ryood/MIDI_CV_CONV/Arduino/readme.txt

MIDI_CV_CONV     Releaseバージョン

MIDI_CV_Test01   Gateを6ch出力
MIDI_CV_Test02   同期してGATEを出力
MIDI_CV_Test03   CV x 2ch (dummy)
MIDI_CV_Test04   CV: ch1:Freq ch:Mod
MIDI_CV_Test05   CV出力をVolt/Octに変更
MIDI_CV_Test06   VRFEFを調整

MIDI_Display_Message_I2C_LCD      MIDIメッセージをUARTで表示
MIDI_Display_Message_I2C_LCD_Gate + GATE出力
