ryood/MIDI_CV_CONV/Arduino MIDI-CV Converter テスト.png

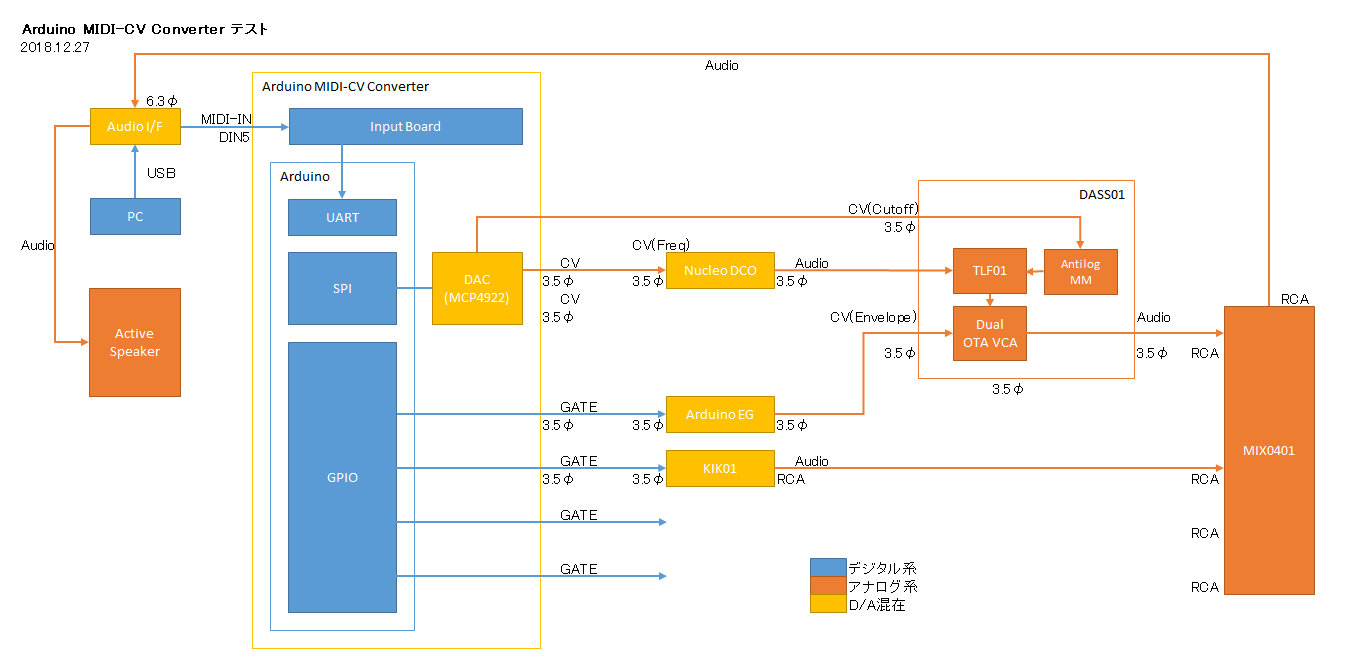
Arduino MIDI-CV Converter テスト.png
