ryood/MIDI_CV_CONV/Arduino MIDI-CV Converter 使用例.png

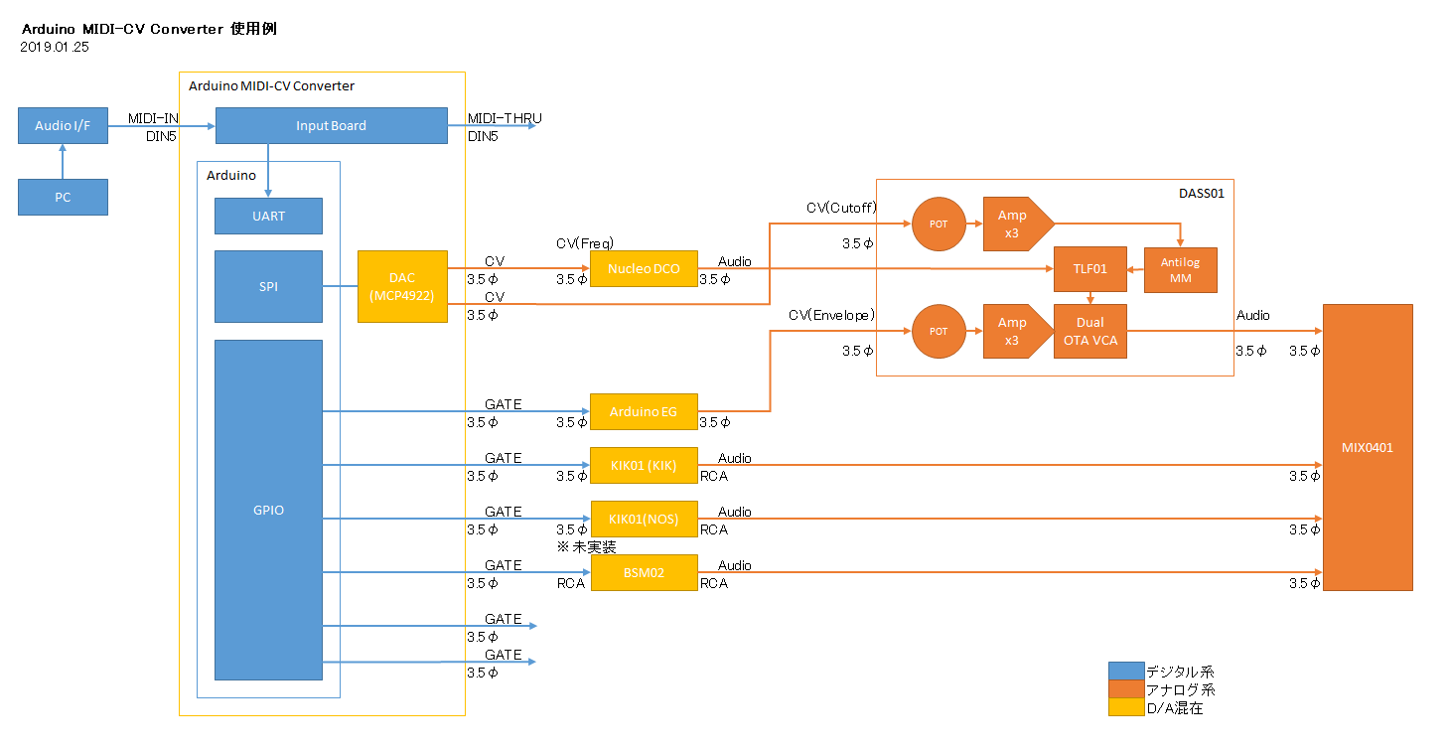
Arduino MIDI-CV Converter 使用例.png
