ryood/MIDI_CV_CONV/eagle/MIDI_CV_CONV/MIDI_CV_CONV_brd.png

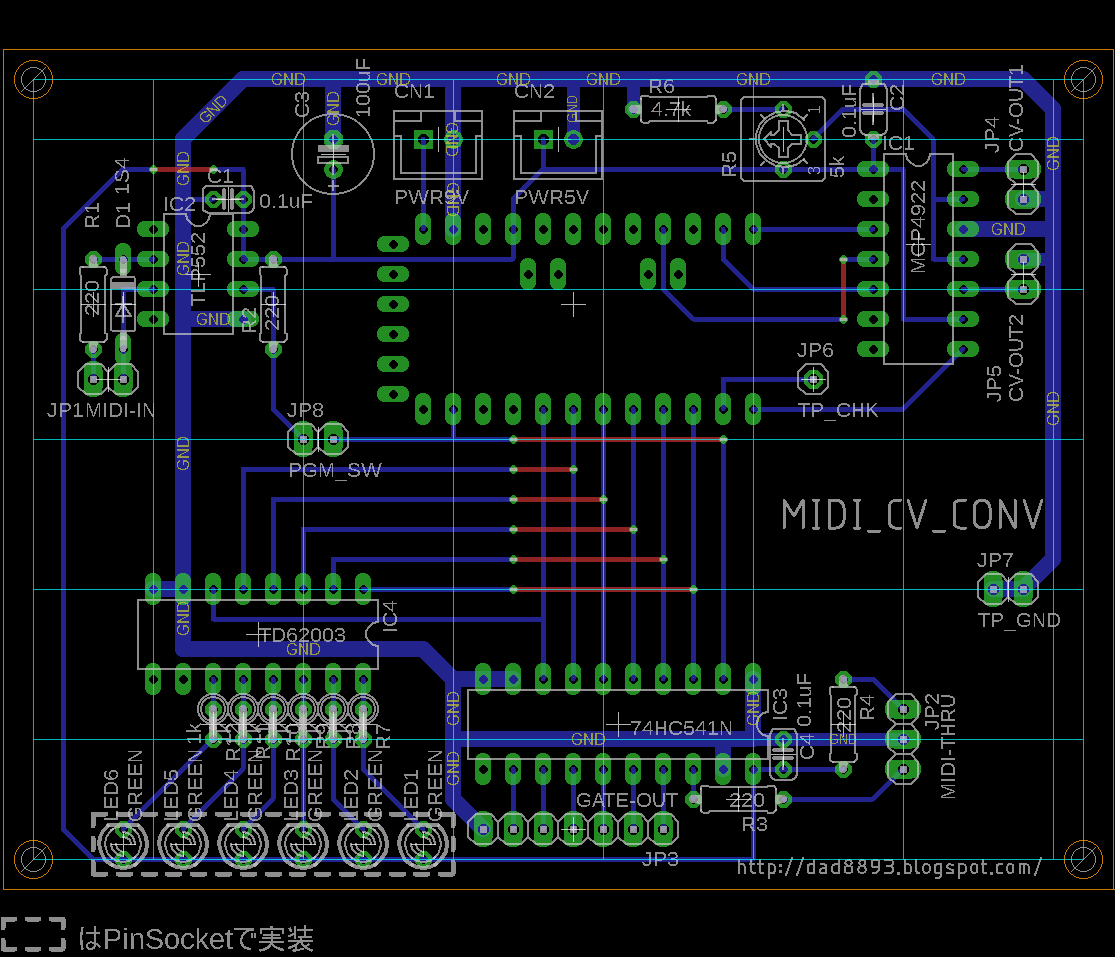
eagle/MIDI_CV_CONV/MIDI_CV_CONV_brd.png
