ryood/MIDI_CV_CONV/eagle/MIDI_CV_CONV/MIDI_CV_CONV_sch.png

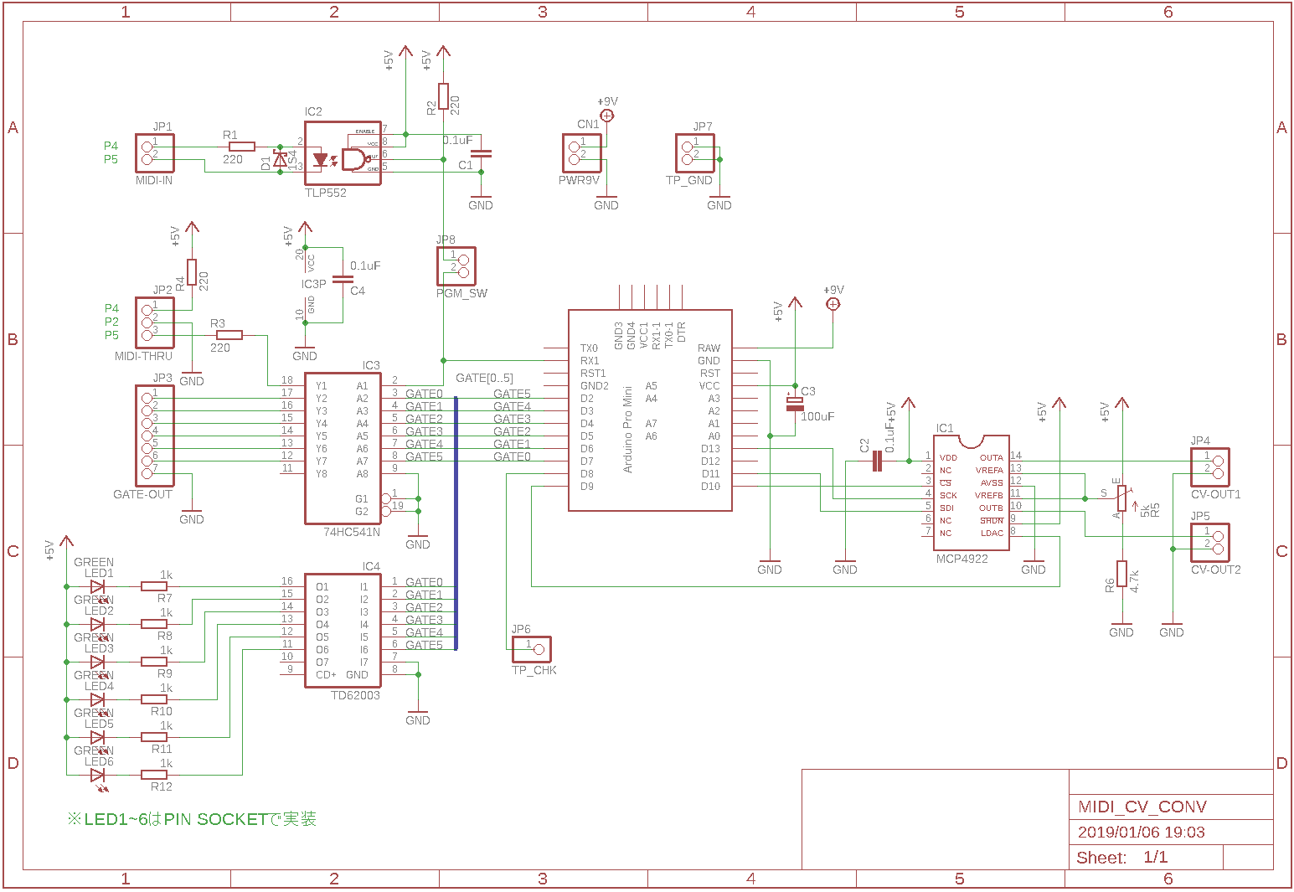
eagle/MIDI_CV_CONV/MIDI_CV_CONV_sch.png
