ryood/MIDI_CV_CONV/Fritzing/MIDI_CV_CONV_ブレッドボード.png

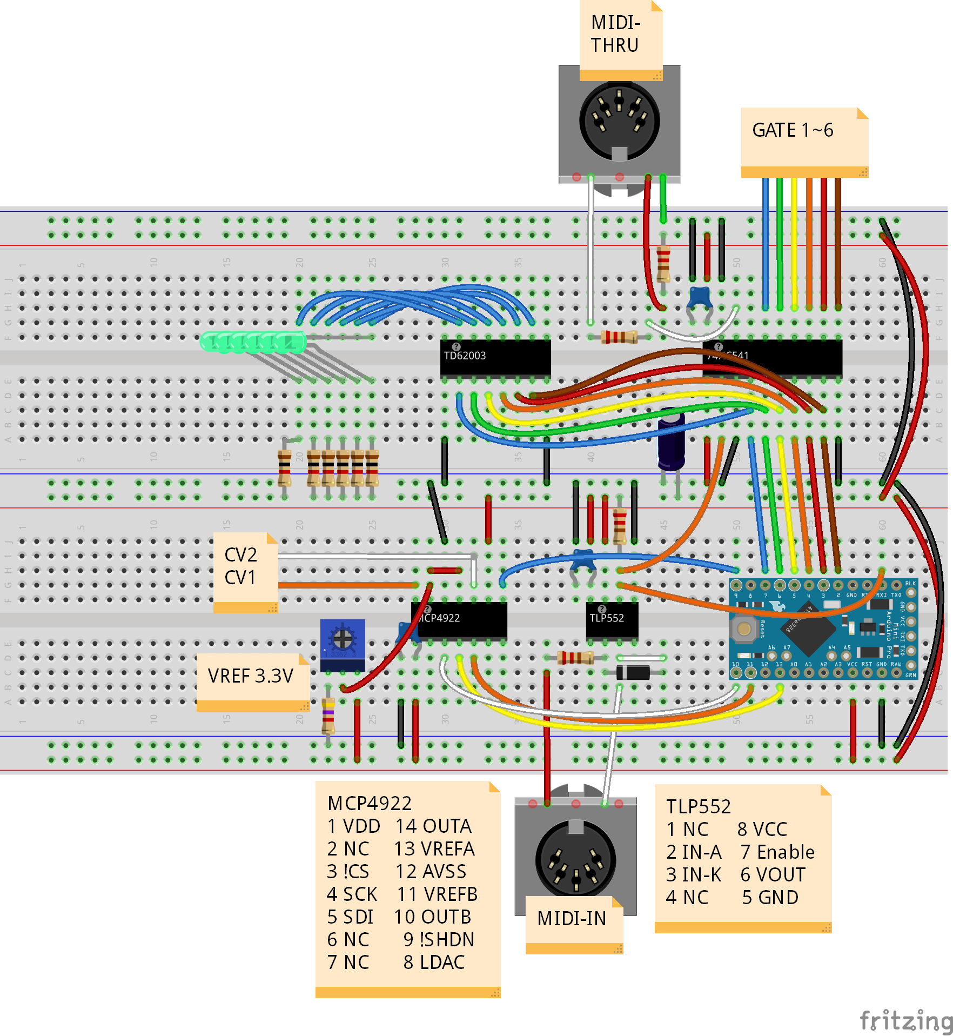
Fritzing/MIDI_CV_CONV_ブレッドボード.png
