ryood/MIDI_CV_CONV/MIDI_CV_CONV ブロック図.png

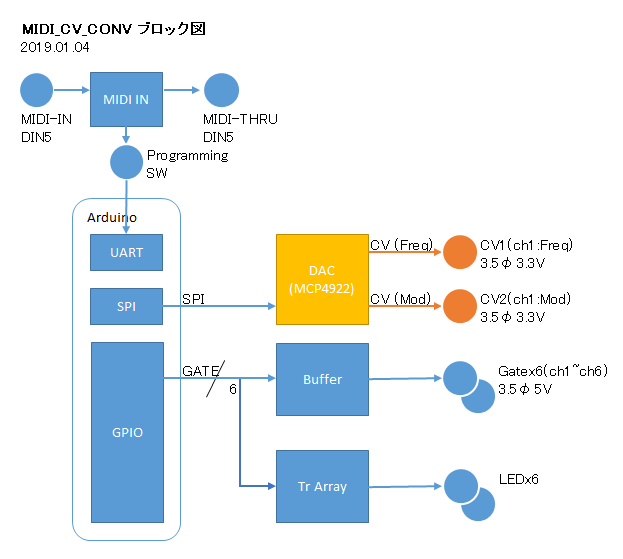
MIDI_CV_CONV ブロック図.png
