ryood/MIDI_CV_CONV/MIDI_CV_CONV+Nucleo_DCO/NucleoDCO+MIDI_CV_CONVブロック図.png

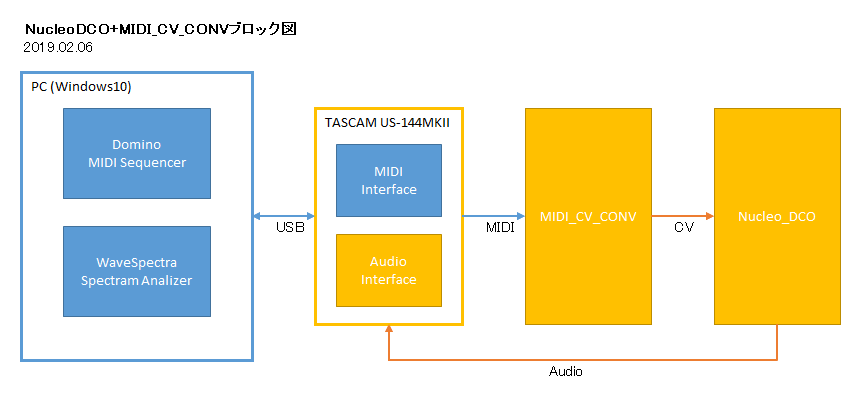
MIDI_CV_CONV+Nucleo_DCO/NucleoDCO+MIDI_CV_CONVブロック図.png
