ryood/MIDI_CV_CONV/MIDI_CV_CONV+Nucleo_DCO/Octave_Graph.png

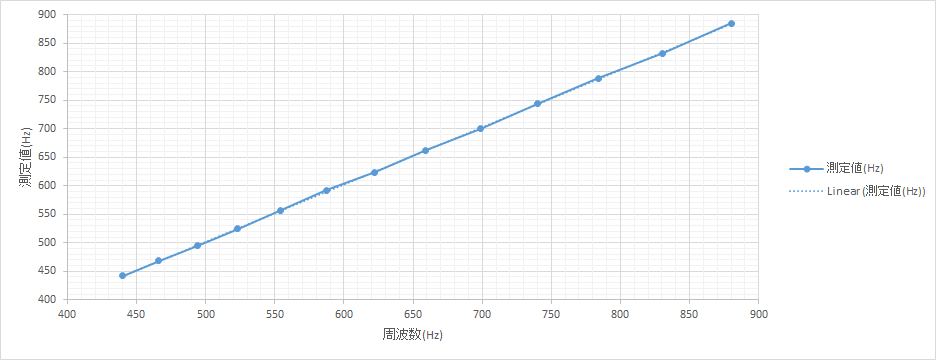
MIDI_CV_CONV+Nucleo_DCO/Octave_Graph.png
