ryood/MIDI_CV_CONV/MIDI_CV_CONV+Nucleo_DCO/Range_Graph.png

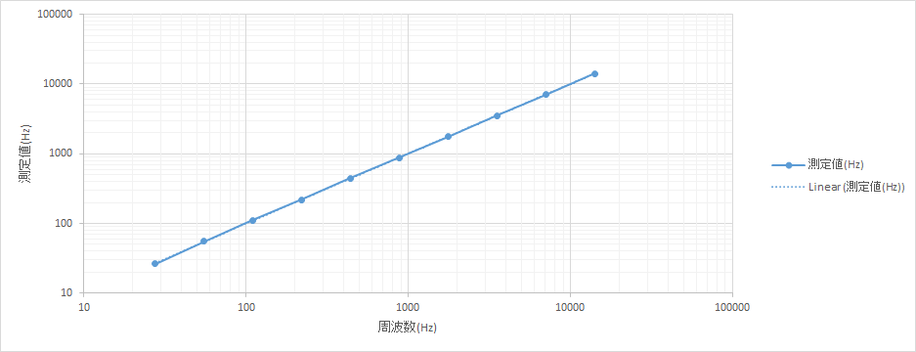
MIDI_CV_CONV+Nucleo_DCO/Range_Graph.png
