ryood/MIDI_CV_CONV/Nucleo MIDI-CV Converter 使用例.png

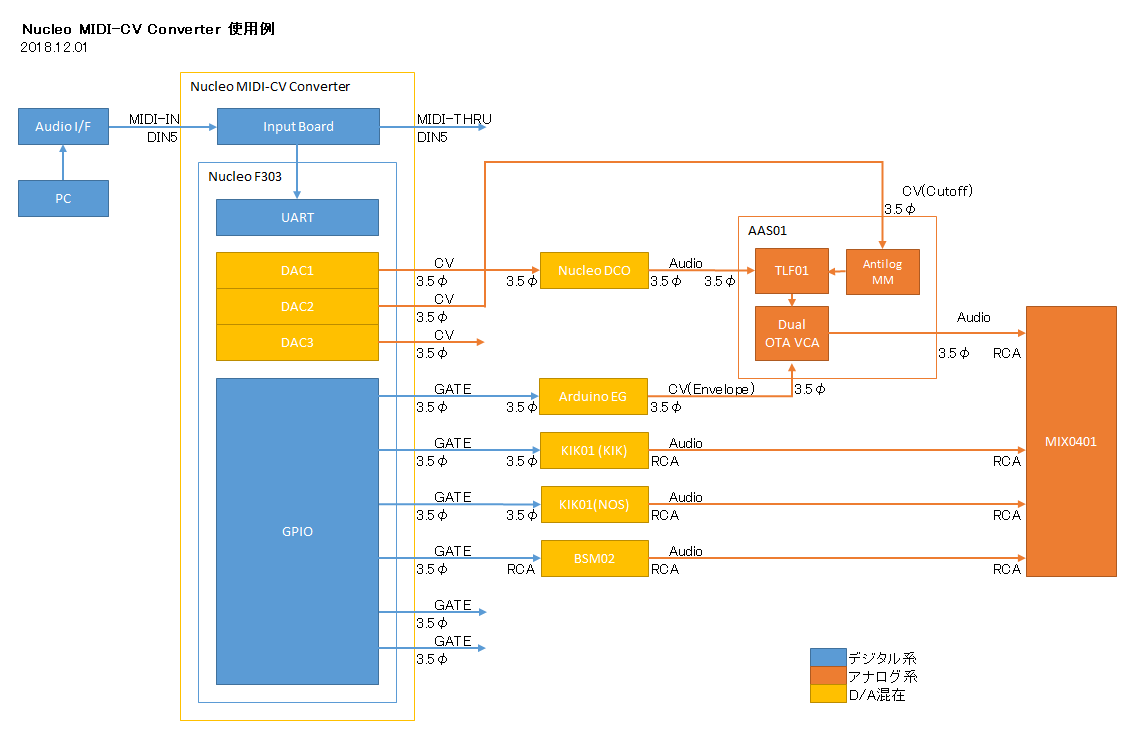
Nucleo MIDI-CV Converter 使用例.png
