ryood/MIDI_CV_CONV/(list of files, cad)

Other CAD files:
case/MIDI_CV_Conv_Case.dwg
case/MIDI_CV_Conv_Case_MockUp.dwg
case/MID_CV_CONV_Test_Panel.dwg
