ryood/MIDI_CV_CONV/Fritzing/MIDI_IN_Test_Arduino_NANO_RLC_LPF_ブレッドボード.png

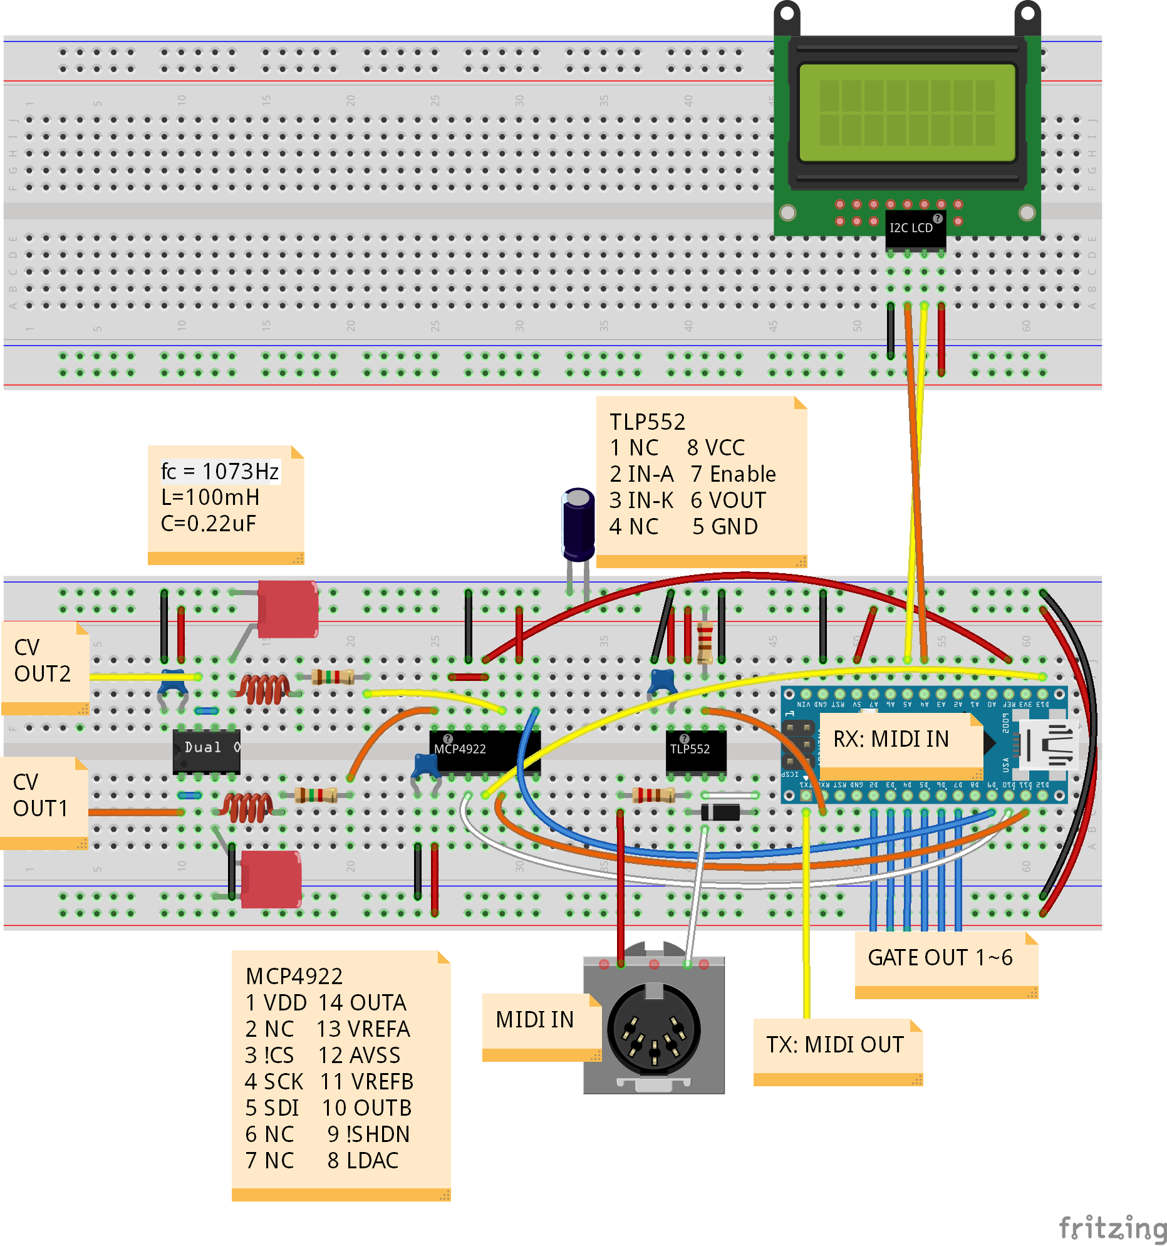
Fritzing/MIDI_IN_Test_Arduino_NANO_RLC_LPF_ブレッドボード.png
