ryood/MIDI_CV_CONV/Fritzing/MIDI_IN_Test_NucleoF303_ブレッドボード.png

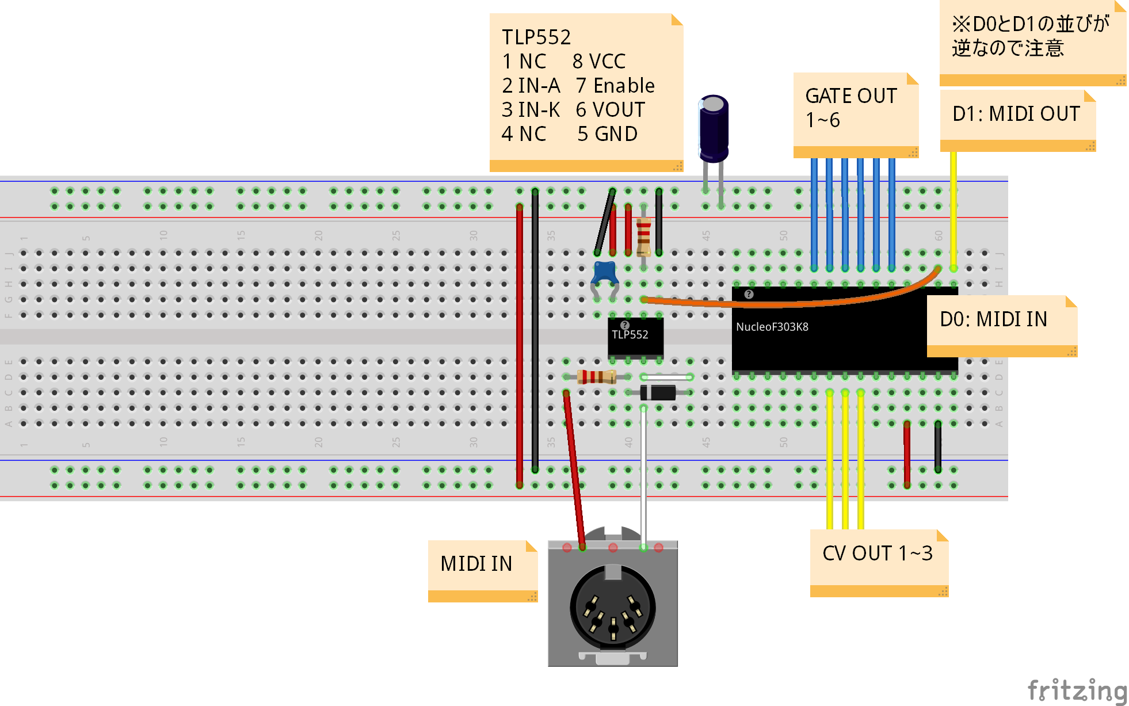
Fritzing/MIDI_IN_Test_NucleoF303_ブレッドボード.png
