ryood/MIDI_CV_CONV/spice/MIDI_CV_CONV_Output_LPF.asc

C1: cap; 0.22u
L1: ind; 100m
R1: res; 1.5k
V1: voltage; PULSE(0 1 0 10n 10n 0.5m 1m); AC 1
Named nets: 0, OUT
;tran 3m
.ac oct 20 10 100k
