ryood/MIDI_CV_CONV/spice/MIDI_CV_CONV_MFB_LPF.asc

C1: cap; 0.022u
C2: cap; 0.0068u
R1: res; 4.7k
R2: res; 8.2k
R3: res; 4.7k
U1: UniversalOpamp2
V1: voltage; PULSE(0 100m 0 10n 10n 100ms 200ms); AC 1
V2: voltage; 5
Named nets: 0, VCC, IN, OUT
.tran 1
