ryood/MIDI_CV_CONV/spice/MIDI_CV_CONV_RLC_LPF.asc

C1: cap; 0.068u
L1: ind; 100m
R1: res; 2.2k
U1: UniversalOpamp2
V1: voltage; PULSE(0 1 0 10n 10n 100ms 200ms); AC 1
V2: voltage; 5
Named nets: 0, IN, VCC, OUT
.tran 1s
;ac oct 20 10 100k
