ryood/MIDI_CV_CONV/spice/MIDI_CV_CONV_VCVS_LPF.asc

C1: cap; 0.01u
C2: cap; 0.01u
R1: res; 8.2k
R2: res; 8.2k
U1: UniversalOpamp2
V1: voltage; PULSE(0 100m 0 10n 10n 100ms 200ms); AC 1
V2: voltage; 5
Named nets: VCC, 0, OUT, IN
;tran 1
.ac oct 20 10 100k
