ryood/MIDI_CV_CONV/spice/PIPO_ShiftRegister.asc

A1: dflop; Vhigh=5
A2: dflop; Vhigh=5
A3: dflop; Vhigh=5
A4: dflop; Vhigh=5
V1: voltage; PULSE(0 3.3 14m 10n 10n 10m 15m)
V2: voltage; PULSE(0 3.3 15m 10n 10n 15m 30m)
V3: voltage; PULSE(0 3.3 16m 10n 10n 15m 30m)
V4: voltage; PULSE(0 3.3 17m 10n 10n 15m 30m)
V5: voltage; PULSE(0 3.3 18m 10n 10n 15m 30m)
Named nets: OUT1, OUT2, OUT3, OUT4, 0, CLK, IN1, IN2, IN3, IN4
.tran 100m
