ryood/MIDI_CV_CONV/(list of files, drawings)

Other design files:
Fritzing/MIDI_CV_CONV.fzz
Fritzing/MIDI_IN_Test_Arduino_NANO.fzz
Fritzing/MIDI_IN_Test_Arduino_NANO_LPF.fzz
Fritzing/MIDI_IN_Test_Arduino_NANO_RLC_LPF.fzz
Fritzing/MIDI_IN_Test_Arduino_NANO_RLC_LPF_DFF.fzz
Fritzing/MIDI_IN_Test_NucleoF303.fzz
