ryood/MIDI_CV_CONV/Arduino/MIDI_CV_CONV/MIDI_CV_CONV.ino

/*
 *  MIDI_CV_CON
 *  
 *  2019.03.07
 */

#include <SPI.h>
#include <Wire.h>
#include <MIDI.h>
#include <I2CLiquidCrystal.h>

#define LED_CHECK   (1)
#define LCD_TRACE   (0)  // LCD_TRACEを有効化(1)すると正常動作しない。
#define PIN_CHECK   (1)
#define TITLE_STR1  ("MIDI_CV_CONV    ")
#define TITLE_STR2  ("20190531        ")

#define DAC_VREF  (3.3f)

// Pin assign
const int GateOutPin1 = 2;
const int GateOutPin2 = 3;
const int GateOutPin3 = 4;
const int GateOutPin4 = 5;
const int GateOutPin5 = 6;
const int GateOutPin6 = 7;

const int CheckPin1   = 8;

const int MCP4922Ldac = 9;
const int MCP4922Cs = 10;

// MIDI
MIDI_CREATE_DEFAULT_INSTANCE();

// MCP4922
SPISettings MCP4922_SPISetting(8000000, MSBFIRST, SPI_MODE0);

// I2C LCD
#if (LCD_TRACE)
I2CLiquidCrystal lcd(63, (bool)true);
#endif

volatile uint8_t cv[2] = {0, 0};
volatile uint8_t gateBits = 0;
volatile int16_t bend = 0;

// MIDI Input Callbacks ------------------------------------------------------------

#if (LCD_TRACE)
void printNoteOnOff(const char* type, byte inChannel, byte inNote, byte inVelocity)
{
  lcd.setCursor(0, 1);
  lcd.print("                ");
  lcd.setCursor(0, 1);
  lcd.print(type);
  lcd.print(' ');
  lcd.print(inChannel);
  lcd.print(' ');
  lcd.print(inNote);
  lcd.print(' ');
  lcd.print(inVelocity);
}
#endif

void handleNoteOn(byte inChannel, byte inNote, byte inVelocity)
{
#if (LCD_TRACE)
  printNoteOnOff("On", inChannel, inNote, inVelocity);
#endif

  // cv
  if (inChannel == 1) {
    cv[0] = inNote;
  }

  // gate
  if (inChannel <= 6) {
    bitSet(gateBits, (inChannel + 1));
  }
}

void handleNoteOff(byte inChannel, byte inNote, byte inVelocity)
{
#if (LCD_TRACE)
  printNoteOnOff("Off", inChannel, inNote, inVelocity);
#endif

  // gate
  if (inChannel <= 6) {
    bitClear(gateBits, (inChannel + 1));
  }
}

void handlePitchBend(byte channel, int _bend)
{
  if (channel == 1) {
    bend = _bend;
  }
}

void handleControlChange(byte channel, byte number, byte value)
{
  // CC:Modulation Ch:1
  if (channel == 1 && number == 0x01) {
    cv[1] = value;
  }
}

// CV/GATE Output --------------------------------------------------------------

// param
//   channel: 0, 1
//   val: 0 .. 4095

void MCP4922Write(bool channel, uint16_t val)
{
  uint16_t cmd = channel << 15 | 0x3000;
  cmd |= (val & 0x0fff);

  //digitalWrite(MCP4922Ldac, HIGH);
  digitalWrite(MCP4922Cs, LOW);
  SPI.transfer(highByte(cmd));
  SPI.transfer(lowByte(cmd));
  digitalWrite(MCP4922Cs, HIGH);
  //digitalWrite(MCP4922Ldac, LOW);
}

void cvWrite()
{
  // CV0
  if (cv[0] >= 33 && cv[0] <= 72) {
    float fbend = (bend / 8192.0f) * 2.0f;
    float ov = ((cv[0] - 33) + fbend) / 12.0f;
    if (ov < 0.0f) {
      ov = 0.0f;
    }
    uint16_t v0 = 4096 * (ov / DAC_VREF);
    if (v0 > 4095) {
      v0 = 4095;
    }
    MCP4922Write(0, v0); 
  }

  // CV1
  MCP4922Write(1, cv[1] << 5);
}

void gateWrite()
{
  PORTD = gateBits;
}

// -----------------------------------------------------------------------------

#if (LED_CHECK) 
void ledCheck()
{
  for (int j = 0; j < 2; j++) {
    gateBits = 1;
    for (int i = 0; i < 7; i++) {
      gateBits = gateBits << 1;
      PORTD = gateBits;
      delay(100);
    }
  }
  gateBits = 0;
  PORTD = gateBits;
}
#endif

void setup()
{
  pinMode(GateOutPin1, OUTPUT);
  pinMode(GateOutPin2, OUTPUT);
  pinMode(GateOutPin3, OUTPUT);
  pinMode(GateOutPin4, OUTPUT);
  pinMode(GateOutPin5, OUTPUT);
  pinMode(GateOutPin6, OUTPUT);
  pinMode(CheckPin1,   OUTPUT);

#if (LED_CHECK)
  ledCheck();
#endif

  pinMode(MCP4922Cs, OUTPUT);
  digitalWrite(MCP4922Cs, HIGH);  // set CS as inactive
  pinMode(MCP4922Ldac, OUTPUT);
  SPI.begin();
  SPI.beginTransaction(MCP4922_SPISetting);

  MIDI.setHandleNoteOn(handleNoteOn);
  MIDI.setHandleNoteOff(handleNoteOff);
  MIDI.setHandlePitchBend(handlePitchBend);
  MIDI.setHandleControlChange(handleControlChange);
  MIDI.begin(MIDI_CHANNEL_OMNI);

#if (LCD_TRACE)
  lcd.begin(16, 2);
  lcd.print(TITLE_STR1);
  lcd.setCursor(0, 1);
  lcd.print(TITLE_STR2);
  delay(2000);
#endif
}

void loop()
{
#if (PIN_CHECK)
  digitalWrite(CheckPin1, HIGH);
#endif

  if (MIDI.read()) {
#if (LCD_TRACE)
    byte type    = MIDI.getType();
    byte channel = MIDI.getChannel();
    byte data1   = MIDI.getData1();
    byte data2   = MIDI.getData2();

    // Display Raw Midi Message
    if (type != 0x80 && type != 0x90) {
      lcd.setCursor(0, 0);
      lcd.print("                ");
      lcd.setCursor(0, 0);
      lcd.print(type, HEX);
      lcd.print(' ');
      lcd.print(channel, HEX);
      lcd.print(' ');
      lcd.print(data1, HEX);
      lcd.print(' ');
      lcd.print(data2, HEX);
    }
#endif
  }

  digitalWrite(MCP4922Ldac, HIGH);
  cvWrite();
  gateWrite();
  digitalWrite(MCP4922Ldac, LOW);

#if (PIN_CHECK)
  digitalWrite(CheckPin1, LOW);
#endif
}
