ryood/MIDI_CV_CONV/Arduino/MIDI_CV_CONV_Test04/noteToBit.h

/*
 * noteToBit.h
 *
 * MIDI Note Numberから12bit値への変換テーブル
 * Note Number = 24から開始
 *
 * 2018.12.12
 *
 */

#ifndef _NOTE_TO_BIT_H_
#define _NOTE_TO_BIT_H_
 
const int noteToBit[] = {
	199	,	// NoteNumber:24
	205	,
	211	,
	217	,
	224	,
	231	,
	239	,
	247	,
	256	,
	265	,
	274	,
	285	,
	296	,
	307	,
	319	,
	332	,
	346	,
	361	,
	376	,
	392	,
	409	,
	428	,
	447	,
	468	,
	489	,
	512	,
	537	,
	563	,
	590	,
	619	,
	650	,
	682	,
	717	,
	754	,
	792	,
	833	,
	877	,
	923	,
	972	,
	1023	,
	1078	,
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
	4007	,	// NoteNumber:88
};

#endif //_NOTE_TO_BIT_H_
