ryood/MIDI_CV_CONV/(commit log)

2018-12-10 Add: MIDI_CV_CONV_Test01
    [Arduino MIDI-CV Converter 使用例 .xlsx]
2018-12-10 Add: MIDI_CV_CONV_Test02
    [MIDI_IN_Test_Arduino_NANO.fzz]
2018-12-12 Add: MIDI_CV_CONV_Test03
    [MIDI_IN_Test_Arduino_NANO.fzz]
2018-12-16 Add: MIDI_IN_Test_Arduino_NANO_LPF.fzz
    [MIDI_IN_Test_Arduino_NANO.fzz, MIDI_IN_Test_Arduino_NANO_LPF.fzz]
2018-12-21 Add: MIDI_CV_CONV_Test05
    [MIDI Note# → Volt_Oct変換.xlsx, MIDI-CV 電圧変換表.xlsx]
2019-01-04 Add: Eagle files
    [Arduino MIDI-CV Converter 使用例 2 .xlsx, MIDI_CV_CONV ブロック図 (ラッチ有り).xlsx, MIDI_CV_CONV.sch, MIDI_IN_Test_Arduino_NANO_RLC_LPF.fzz, MIDI_IN_Test_Arduino_NANO_RLC_LPF_DFF.fzz]
2019-01-06 Add: Board Design
    [MIDI_CV_CONV ブロック図 (ラッチ有り).xlsx, MIDI_CV_CONV ブロック図 .xlsx, MIDI_CV_CONV.brd, MIDI_CV_CONV.sch]
2019-01-19 Finish Soldering
    [MIDI_CV_CONV 接続表.xlsx, MIDI_CV_CONV.brd, MIDI_CV_CONV.fzz, MIDI_CV_CONVテスト表.xlsx]
2019-01-24 Add: Test Panel Design
    [MID_CV_CONV_Test_Panel.dwg]
2019-01-25 Update: Block Diagram
    [Arduino MIDI-CV Converter 使用例 .xlsx, Arduino MIDI-CV Converter 使用例 2 .xlsx]
2019-03-27 Add: 5V Power Supply
    [MIDI_CV_CONV.brd, MIDI_CV_CONV.sch]
2019-05-31 Add: LED Check
